mnorden81/RC-Multiswitch-Sound-ESP32-S3/hardware/gehaeuse/Gehaeuse3D_Vorschau_gewinkelt.html

# Gehäuse mit gewinkelter Stiftleiste J1

RC-Multiswitch-Sound-ESP32-S3, Platine v0.9, Gehäuse-Version „gewinkelt“. Die 8 Ausgänge kommen als gewinkelte Stiftleiste 2×8 vorne durch die Wand, der Deckel ist über J1 geschlossen. Mit „Alt“ siehst du den ersten, zu knappen Schlitz zum Vergleich.

Schlitz J121,5 × 8,6

Luft unten2,6 mm

Außen117,2 × 78,2

Ziehen = drehen · Mausrad/zwei Finger = zoomen · rechte Maustaste = schieben

Gehäuse Alt (bis 06.11.2026) Aktuell

Ansicht Schräg Vorne Nah an J1 Von innen

Zeigen Deckel Dupont-Stecker Wand durchsichtig

## Schnitt durch einen Ausgang (maßstäblich)

Seitenansicht quer zur Vorderwand, links ist außen. Stecker Dupont 1×2 (2,5 × 5,0 mm), Leiste nach KiCad-Footprint PinHeader_2x08_P2.54mm_Horizontal: untere Stiftreihe 1,27 mm, obere 3,81 mm über der Platine.

Alt 0,2 mm Luft

Aktuell 2,6 mm Luft

## Stiftleiste einbauen

- Teil: Stiftleiste 2×8, Raster 2,54 mm, gewinkelt (90°), Kunststoff 2,5 mm, Stifte ca. 6 mm lang.
- In die vorhandenen Löcher von J1 löten, der Kunststoffkörper zeigt zur vorderen Platinenkante. Die Platine bleibt unverändert.
- Der Körper steht ca. 0,6 mm über die Platinenkante. Die Leiste flach auf die Platine drücken und erst einen Stift löten, dann ausrichten.
- Belegung: obere Reihe = Ausgänge 1-8 (ungerade Pins), untere Reihe = VLOAD (gerade Pins).

## Schlitz in der Vorderwand

- 21,5 × 8,6 mm, von 1 mm unter der Platinen-Unterseite bis 6 mm über der Platinen-Oberseite.
- Die Vorderwand ist dort 4,4 mm dick. Die Stifte ragen 1,6 mm aus der Wand, die Stecker werden 4,4 mm tief in den Schlitz geschoben.
- Passt für 8 Dupont-Stecker 1×2 nebeneinander (je 2,54 × 5,08 mm) oder einen Stecker 2×8.
- Unten bleiben 2,6 mm Luft, falls die Leiste etwas tiefer sitzt. Unter dem Schlitz bleiben 4 mm Wand bis zum Boden.
