mnorden81/RC-Multiswitch-Sound-ESP32-S3/hardware/gehaeuse/Gehaeuse_Unterteil_gewinkelt.step

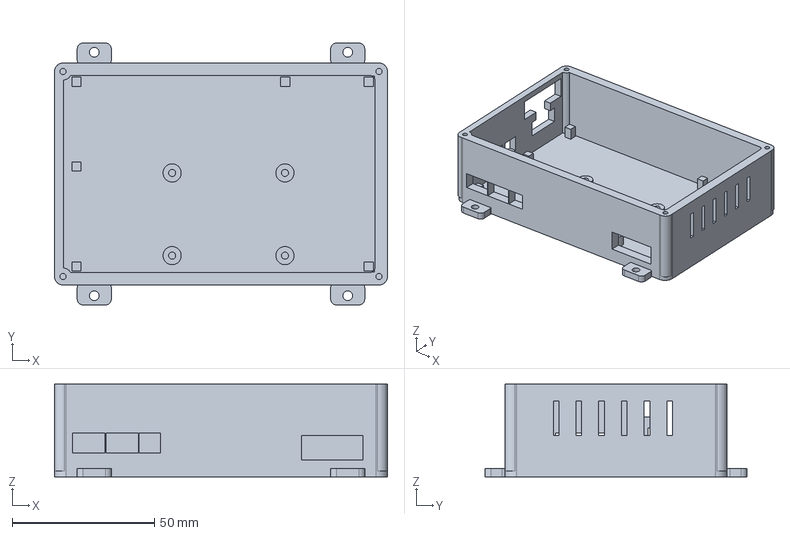
[picture p4: CAD file, 2026-11-06]
hardware/gehaeuse/Gehaeuse_Unterteil_gewinkelt.step
117.2 x 92.2 x 32.6 mm
