mnorden81/RC-Multiswitch-Sound-ESP32-S3/(list of files, cad)

Other CAD files:
hardware/gehaeuse/Gehaeuse_Unterteil_gewinkelt.stl
