mnorden81/RC-Multiswitch-Sound-ESP32-S3/(commit log)

2026-11-06 Firmware v1.01: baut auch mit esp32-Core 3.3.x
    BOOT_PIN heisst jetzt BOOT_BTN_PIN, weil esp32 3.3.x BOOT_PIN selbst
    definiert (Fehler 'redefinition of BOOT_PIN'). CI baut zusaetzlich mit
    3.3.12 als Kompiliertest.
    Claude-Session: https://claude.ai/code/session_0118D4qpbKhkNdrayBKZReeW
2026-11-06 Gehaeuse gewinkelt: J1-Schlitz bis unter die Platine, Doku ergaenzt
    - gehaeuse.py: neuer Parameter J1_SCHLITZ_U, Schlitz fuer die gewinkelte
    Stiftleiste reicht jetzt bis 1 mm unter die Platinen-Unterseite
    (21,5 x 8,6 statt 21,5 x 6,2 mm). Unten 2,6 mm Luft fuer die Stecker
    statt 0,2 mm.
    - Gehaeuse_Unterteil_gewinkelt.stl/.step neu erzeugt (Deckel unveraendert).
    - 3D-Vorschau gewinkelt neu: bestueckte Platine, Stiftleiste, Dupont-Stecker,
    Umschalter alt/aktuell, massstaeblicher Schnitt durch einen Ausgang.
    - README Gehaeuse: Abschnitt Stiftleiste und Schlitz, Bilder; Korrektur:
    Stifte ragen 1,6 mm (nicht 3,8 mm) aus der 4,4 mm dicken Vorderwand.
    - README und Projektbeschreibung: J1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
    [Gehaeuse_Unterteil_gewinkelt.step, Gehaeuse_Unterteil_gewinkelt.stl]
2026-11-10 Autor: PiperPilot statt vollem Namen (#14)
    Voller Name in Code-Kommentaren und DOCX (Autor-Feld und Text)
    durch PiperPilot ersetzt.
    Claude-Session: https://claude.ai/code/session_0118D4qsuskq7CY6JdgR6nyy
2026-11-13 Lua: Kanal-Felder bleiben Zahlenfelder (Kanalwahl ohne Menue-Verlassen)
    Bei Quelle Aus/Dauer wurde 'Kanal Nr' zum Info-Feld 'Deaktiviert'. Das
    ELRS-Lua-Skript laedt nach einer Aenderung der Quelle nur Zahlen- und
    Auswahlfelder neu, daher liess sich der Kanal nach dem Umstellen (z. B.
    auf EK) erst nach Verlassen des Menues aendern. Jetzt bleibt das Feld
    ein Zahlenfeld und ist bei Aus/Dauer gesperrt (min = max).
    Claude-Session: https://claude.ai/code/session_0118D4qtmncHargSS3A41WBD
2026-11-14 Lua: PWM Festwert bleibt bei MWprop ein Zahlenfeld
    Bei PWM Modus MWprop wurde 'PWM Festwert' zum Info-Feld. Das ELRS-Lua-
    Skript laedt nach einer Aenderung nur Zahlen- und Auswahlfelder neu, daher
    liess sich der Festwert nach dem Zurueckstellen auf Festwert erst nach
    Verlassen des Menues einstellen. Jetzt bleibt es ein Zahlenfeld und ist
    bei MWprop gesperrt (min = max).
    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
2026-11-14 README: Anleitung zum Flashen
    Schritt-fuer-Schritt-Anleitung fuer Martin (Arduino IDE, fertige Datei
    aus GitHub Actions, Update per WLAN). Nur README, kein Code.
    Claude-Session: https://claude.ai/code/session_0118D4qqum127kn2FfD8dkis
2026-11-14 v1.04: SD-Karte als USB-Laufwerk am PC (USB-OTG/TinyUSB)
    Buchse USB an einen PC: die SD-Karte erscheint als Laufwerk (USB MSC).
    Waehrend das Laufwerk am PC haengt, ist der Sound pausiert und das
    Dateisystem gesperrt; Auswerfen/Abziehen bindet die Karte neu ein.
    CI baut mit USBMode=default, Gegenprobe mit hwcdc (ohne Laufwerk).
    Claude-Session: https://claude.ai/code/session_0118D4qpiXHoZStUTWWk4m7T
2026-11-14 v1.05: Lua-Menue uebersichtlicher (RC_Common 1.3.0)
    - RC_Common 1.2.1 Chunk-Fix: lange Auswahlfelder (RC-System,
    Ausgang-Quelle, UART-Baudrate) werden Chunk fuer Chunk beantwortet
    - RC_Common 1.3.0: Lua-Felder ausblendbar (CRSF hidden, Bit 7 im Typ)
    - Ordnernamen zeigen den aktuellen Wert (Ausgang, Sound, Motor,
    Einstellungen, UART B/C, Global)
    - SBUS-only-Felder, Blinkzeiten bei Dauerlicht, PWM Festwert bei MWprop,
    Kanal Nr bei Dauer/Aus, Kanal Speed bei Deaktiviert und Baudrate bei
    Port Aus ausgeblendet; Feld-IDs unveraendert
    - Versionszeile im Lua korrigiert
    Claude-Session: https://claude.ai/code/session_0118D4qs42NFJUudn7WP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
    [RC_Multiswitch_Sound.ino, sound.cpp, test_common.cpp]
2026-11-14 Platine: Silkscreen + und - ergaenzt
    [RC-Multiswitch-Sound-ESP32-S3.kicad_pcb]
